haliburt/AlexaPi/README.md

# AlexaPi
The software connects the ESP8266 to both WiFi and the MQTT server (hosted by homeassistant). The hardware is used to create wireless smart switches for a home automation project.
