haliburt/AlexaPi/CAD Files/Smart Switch Board.pdf

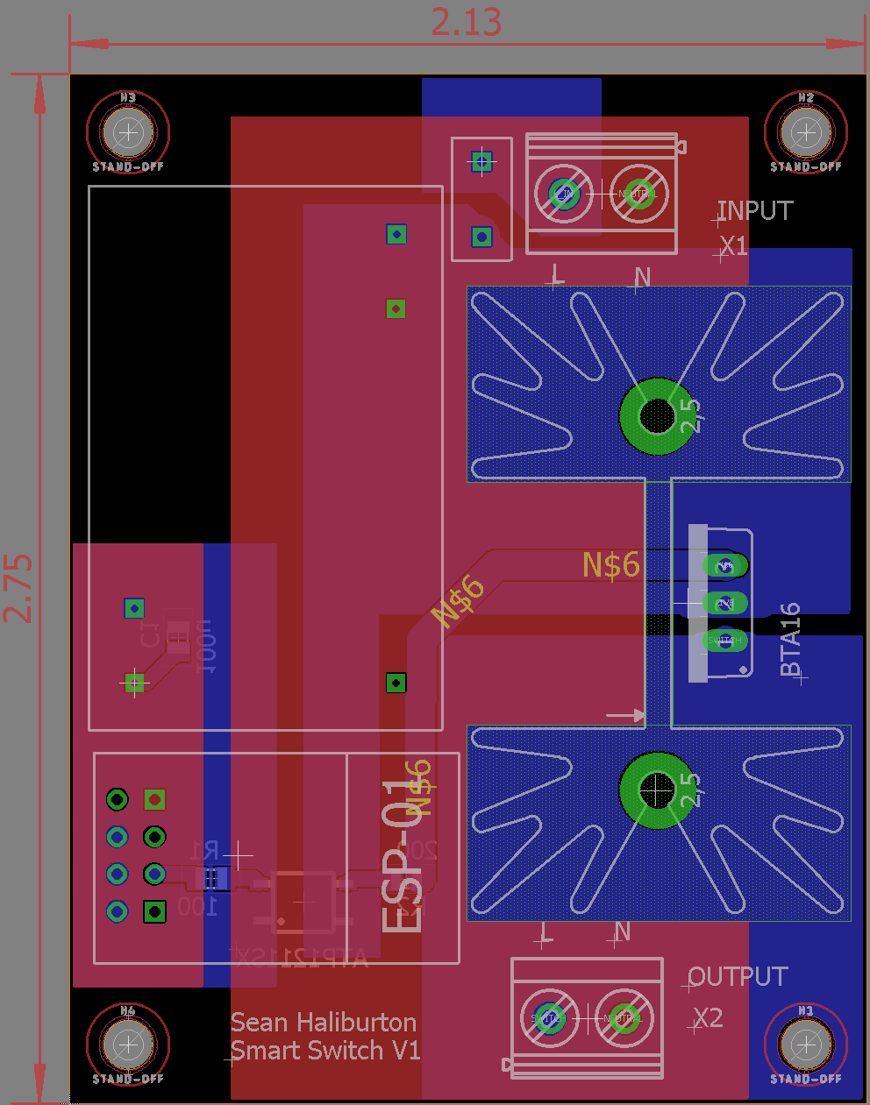
[picture p1: figure]
