haliburt/AlexaPi/CAD Files/Transformerless AC-DC Converter.PNG

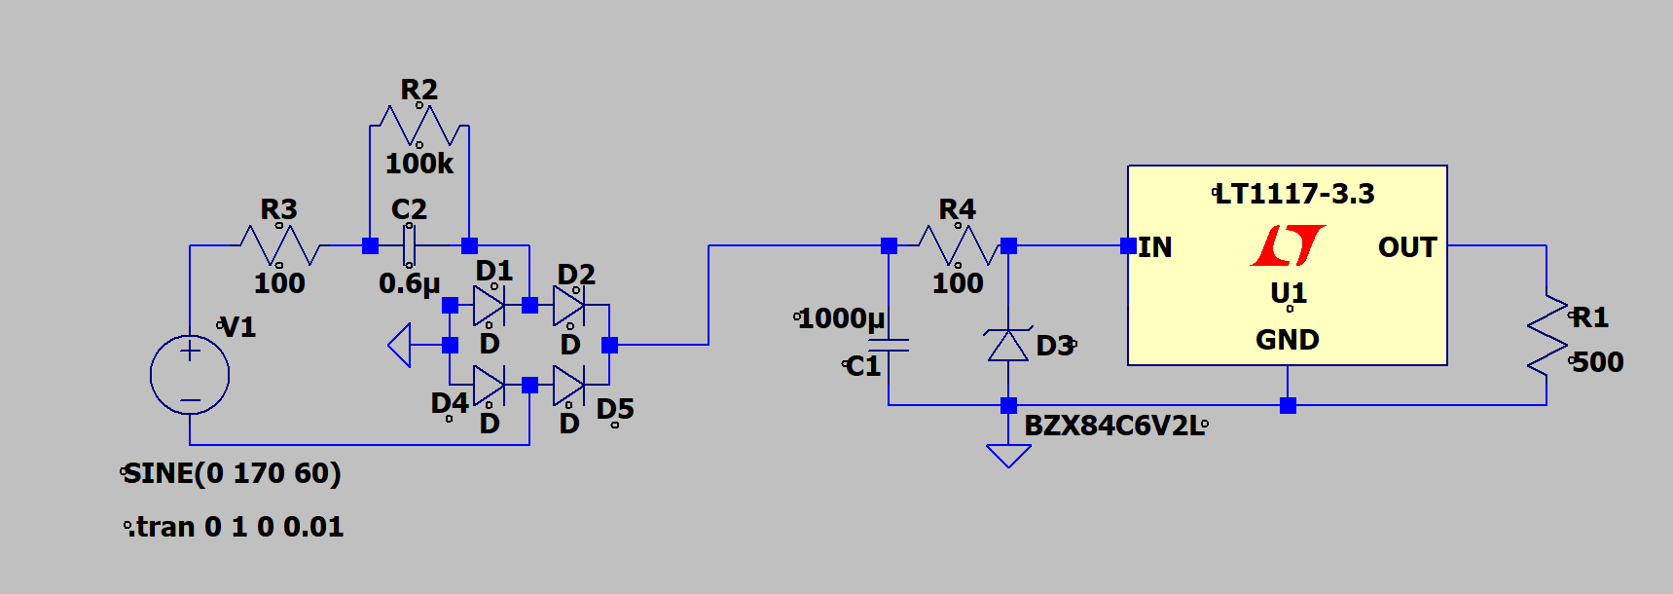
CAD Files/Transformerless AC-DC Converter.PNG
