haliburt/AlexaPi/CAD Files/Smart Switch Schematic.pdf

1 | 2 | 3 | 4

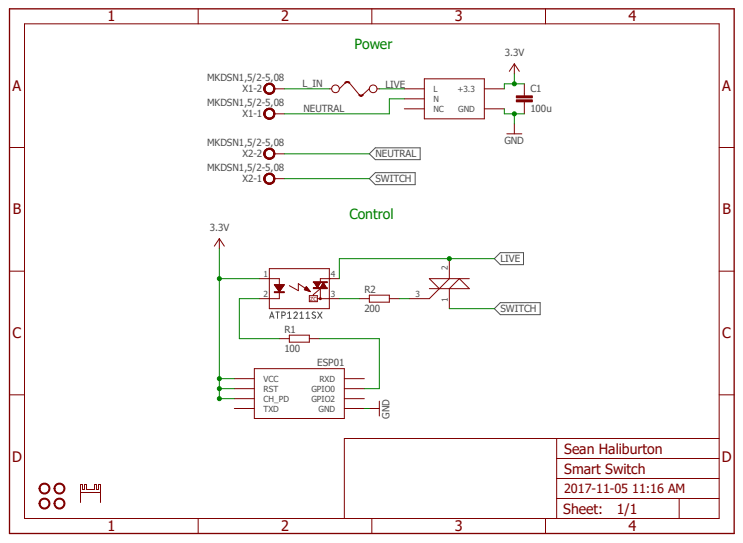
[picture p3: page 1]
GND; MKDSN1,5/2-5,08; GPIO2; GPIO0 RXD; TXD; RST; VCC; ESP01; LIVE; NEUTRAL; SWITCH; Sean Haliburton; Smart Switch 2017-11-05 11:16 AM Sheet: 1/1; Control

Power MKDSN1,5/2-5,08 MKDSN1,5/2-5,08 3.3V
