haliburt/AlexaPi/CAD Files/Transformerless AC-DC Converter.asc

C1: cap; 1000µ
C2: cap; 0.56µ; V=200 Irms=3.97 Rser=0.0278054 Lser=0 mfg="KEMET" pn="C2220C564K2RAC" type="X7R"
D1: diode
D2: diode
D3: zener; BZX84C6V2L
D4: diode
D5: diode
R1: res; 500
R2: res; 100k
R3: res; 100
R4: res; 100
R5: res; 200
R6: res; 100
R7: res; 200
U1: LT1117-3.3
U2: TRIAC
U4: PC817D
V1: voltage; SINE(0 170 60)
Named nets: 0, 3.3, LIVE, SWITCH, NEUTRAL
.tran 0 1 0 0.01
