haliburt/AlexaPi/CAD Files/Smart Switch.brd

## EAGLE design CAD Files/Smart Switch.brd (2017-11-06)

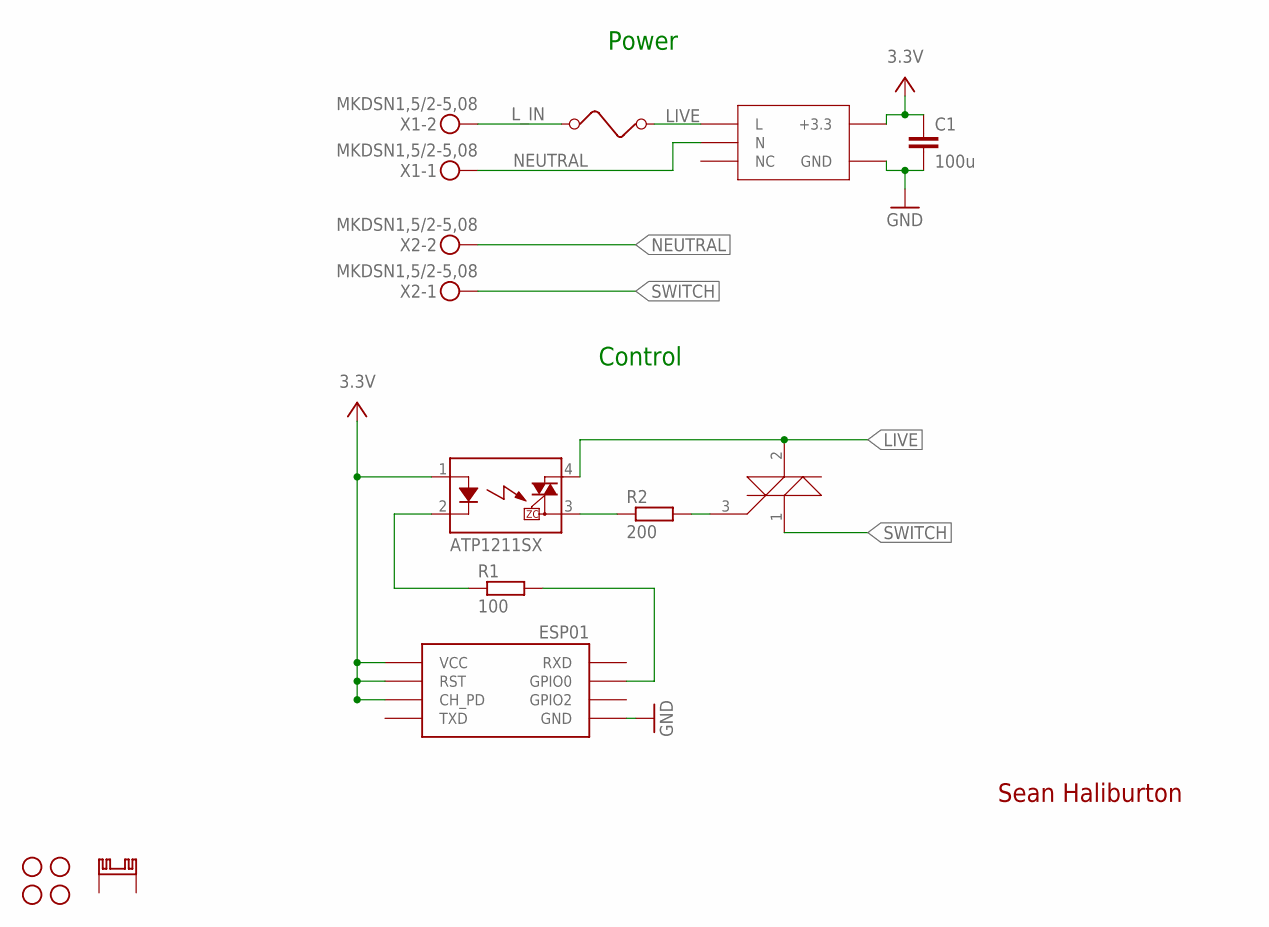
[picture p4: schematic Smart Switch.sch]

Parts:
C1: 100u; C0805
H1, H2, H3, H4: STAND-OFF
K1: ATP1211SX; SOP04
R1: 100; R0805
R2: 200; R0805
U$1: ESP01
U$2: RAC04-GB
U$3: BTA16; TO220V
U$4: FUSE
U$5: RA-T2X-38E; SK129
X1, X2: MKDSN1,5/2-5,08

Connections:
GND: C1.2, U$1.GND, U$2.GND
GPIO0: R1.2, U$1.GPIO0
LIVE: K1.4 (DS1), U$2.L, U$3.2 (A2), U$4.P$2 (2)
L_IN: U$4.P$1 (1), X1.2
unnamed: K1.2 (K), R1.1
unnamed: K1.3 (DS2), R2.1
unnamed: R2.2, U$3.3 (G)
NEUTRAL: U$2.N, X1.1, X2.2
SWITCH: U$3.1 (A1), X2.1
VCC: C1.1, K1.1 (A), U$1.CH_PD, U$1.RST, U$1.VCC, U$2.3.3 (+3.3)

Notes on the sheet:
Sean Haliburton
Power
Control

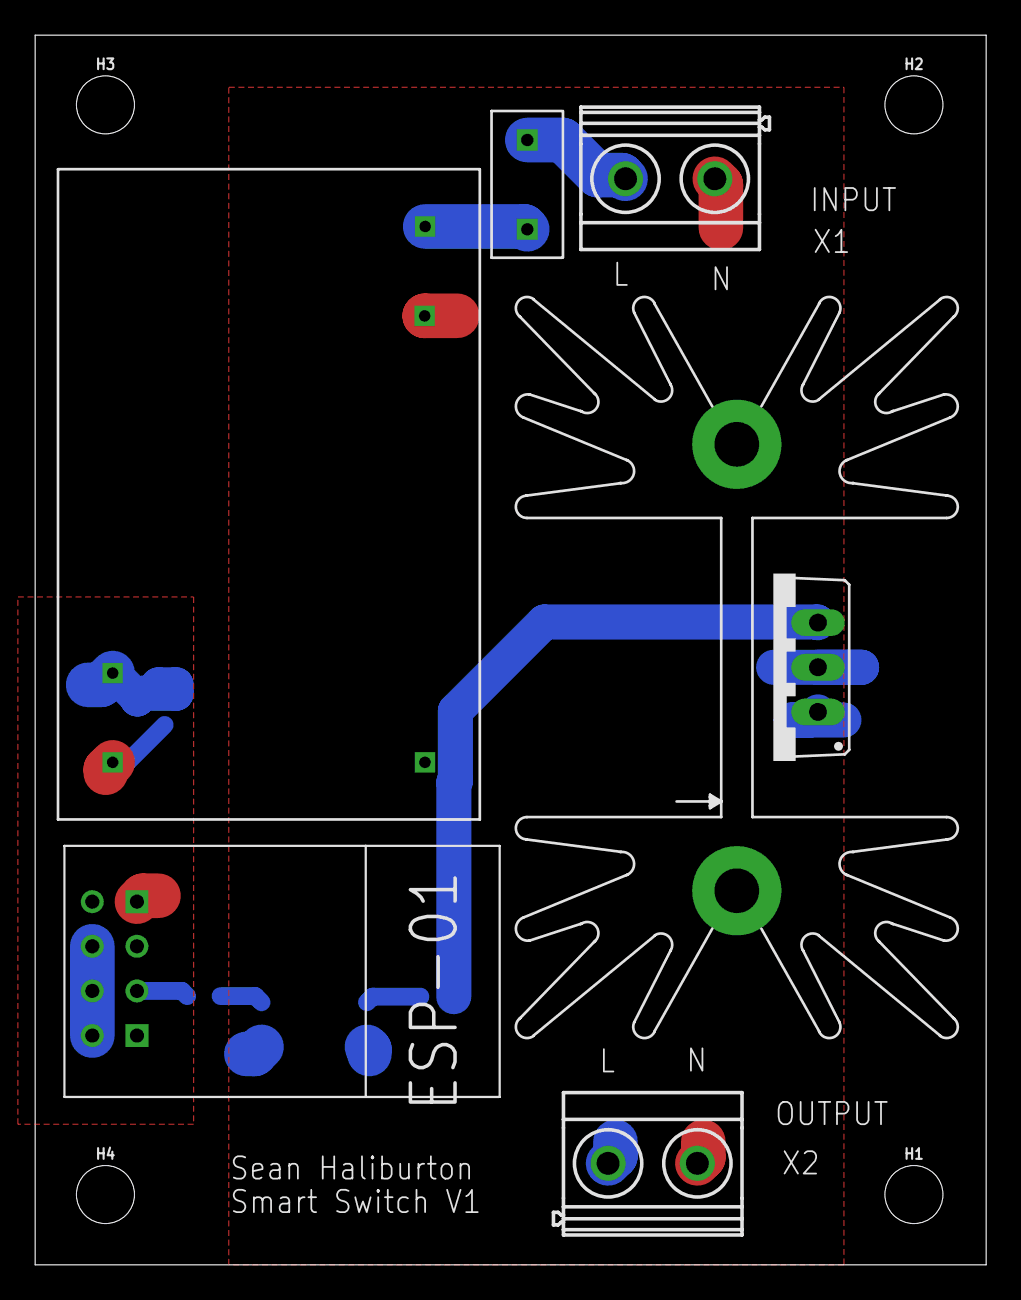
[picture p5: board Smart Switch.brd from above]

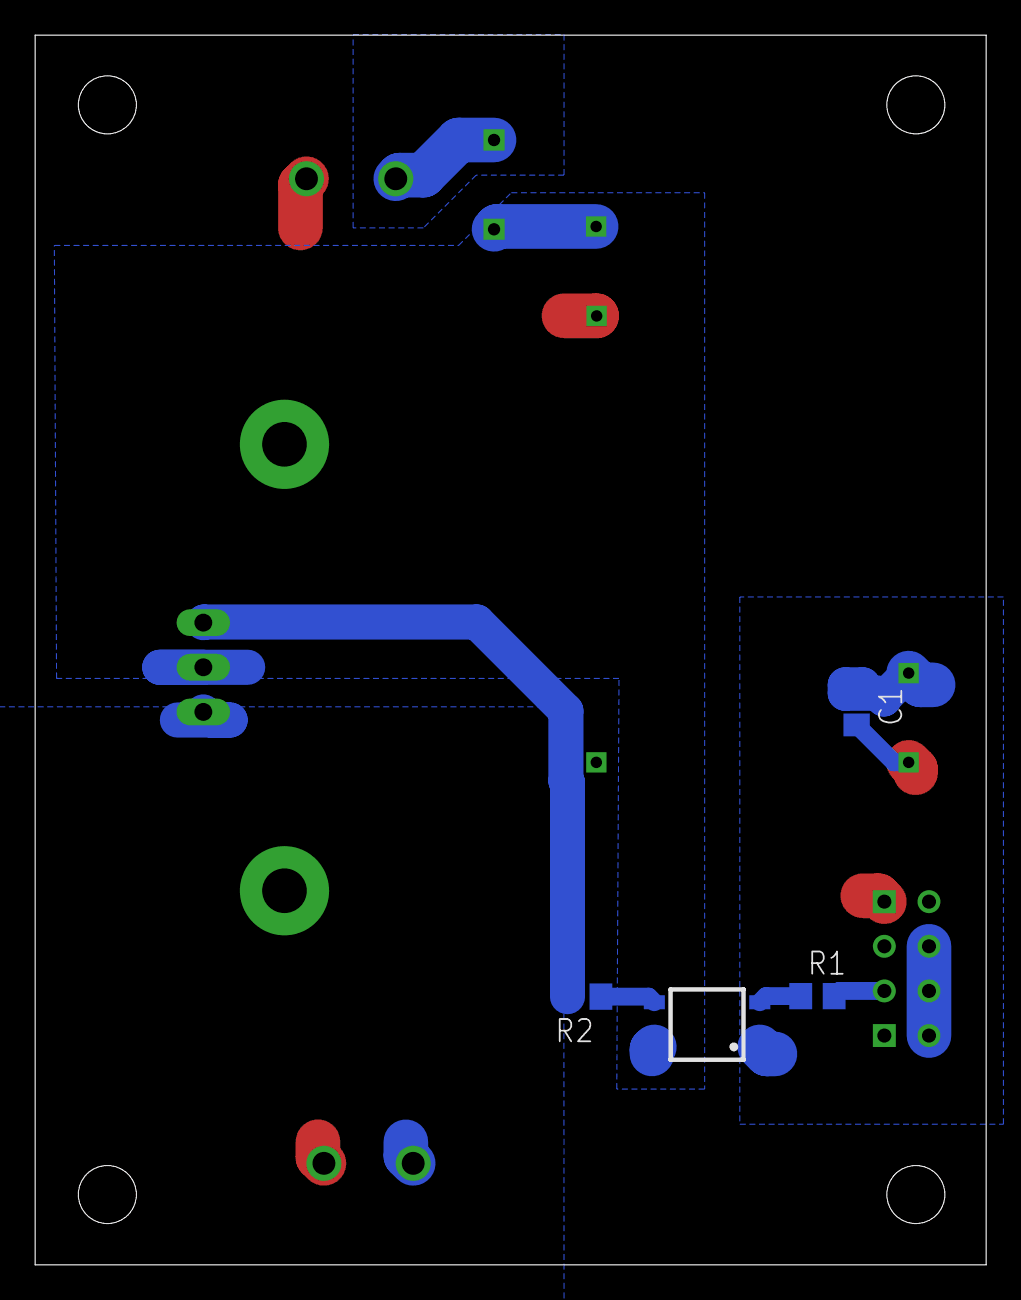
[picture p6: board Smart Switch.brd from below]

Board: 2 copper layers, 54.1 x 70.0 mm, 15 parts (4 on the bottom side), 10 nets.
