haliburt/AlexaPi/(threads)

Thread 2 (2017-09-22):

Relay is latching.

haliburt, 2017-09-22:
Relay twitches if I hold the input pin HIGH. Need to adjust so that it goes HIGH, then open circuits.

Closed 2017-09-24.

Thread 3 (2017-10-08):

AC-DC conversion

haliburt, 2017-10-08:
Design a converter that does not use a transformer. Available transformers work but are too large and expensive relative to the rest of the circuit.

haliburt, 2017-10-08:
This can also get rid of the 5V to 3.3V converter potentially.

Closed 2017-10-11.

Thread 4 (2017-10-08):

Add fuse

haliburt, 2017-10-08:
A breaker will trip if the load current combined with my circuit goes to higher than 15A, a fuse here is not needed. This fuse should be used to protect my circuitry, not the load.

haliburt, 2017-10-08:
A breaker will trip if the load combined with my circuit goes to higher than 15A, a fuse here is not needed. This fuse should be used to protect my circuitry, not the load.

Closed 2017-11-06.

Thread 5 (2017-10-08):

Switch box feed

haliburt, 2017-10-08:
Regular household switches do not require the neutral line to be fed into the box, they only break the circuit to the load on the live line. My circuit design needs a constant 120V supply and therefore needs the neutral line present to work. Possible fix is to use the ground line as a replacement. Need to research if this is how current smart switches function, as this problem would not be exclusive to me.

Ground line current would be maximum of about 100mA (30mA typical).

*This circuit will still work in existing outlet boxes, but as noted may not always work inside a switch box.
