haliburt/AlexaPi/(commit log)

2017-09-14 First version of smart switch control
2017-09-14 Initial hardware design for smart switches
    [Smart Switch.sch]
2017-09-14 Added first version of the schematic
    [Smart Switch.sch]
2017-09-14 Added pdf of schematic
2017-09-18 Added final schematic and board layout
    [Smart Switch.brd, Smart Switch.sch]
2017-10-10 Transformerless AC-DC converter
    - Added the spice simulation. Real design needs a fuse on the live line and an X Rated capacitor; I will need to research if it is possible to drop that much voltage across one of these capacitors. Making this change will reduce manufacturing cost and the board size drastically however efficiency is reduced and heat may be an issue.
    *Will look into adding a series capacitor to the neutral side, as well as a filter for possible high frequency voltage spikes on the main lines.
    **Circuit is no longer galvanically isolated from mains power and is more dangerous. Do not work on the circuit when it is live. As a result this will be the last thing I implement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
2017-10-11 Changed most of the design
    Replaced relay with triac and opto isolator
    Replaced transformer with alternative AC-DC converter
    [Smart Switch.sch]
2017-11-06 Revision was sent for manufacturing
    [Smart Switch.brd, Smart Switch.sch]
